mhdimo/Arius80-HE/MUX.kicad_sch

## KiCad design MUX.kicad_sch (2024-11-28)

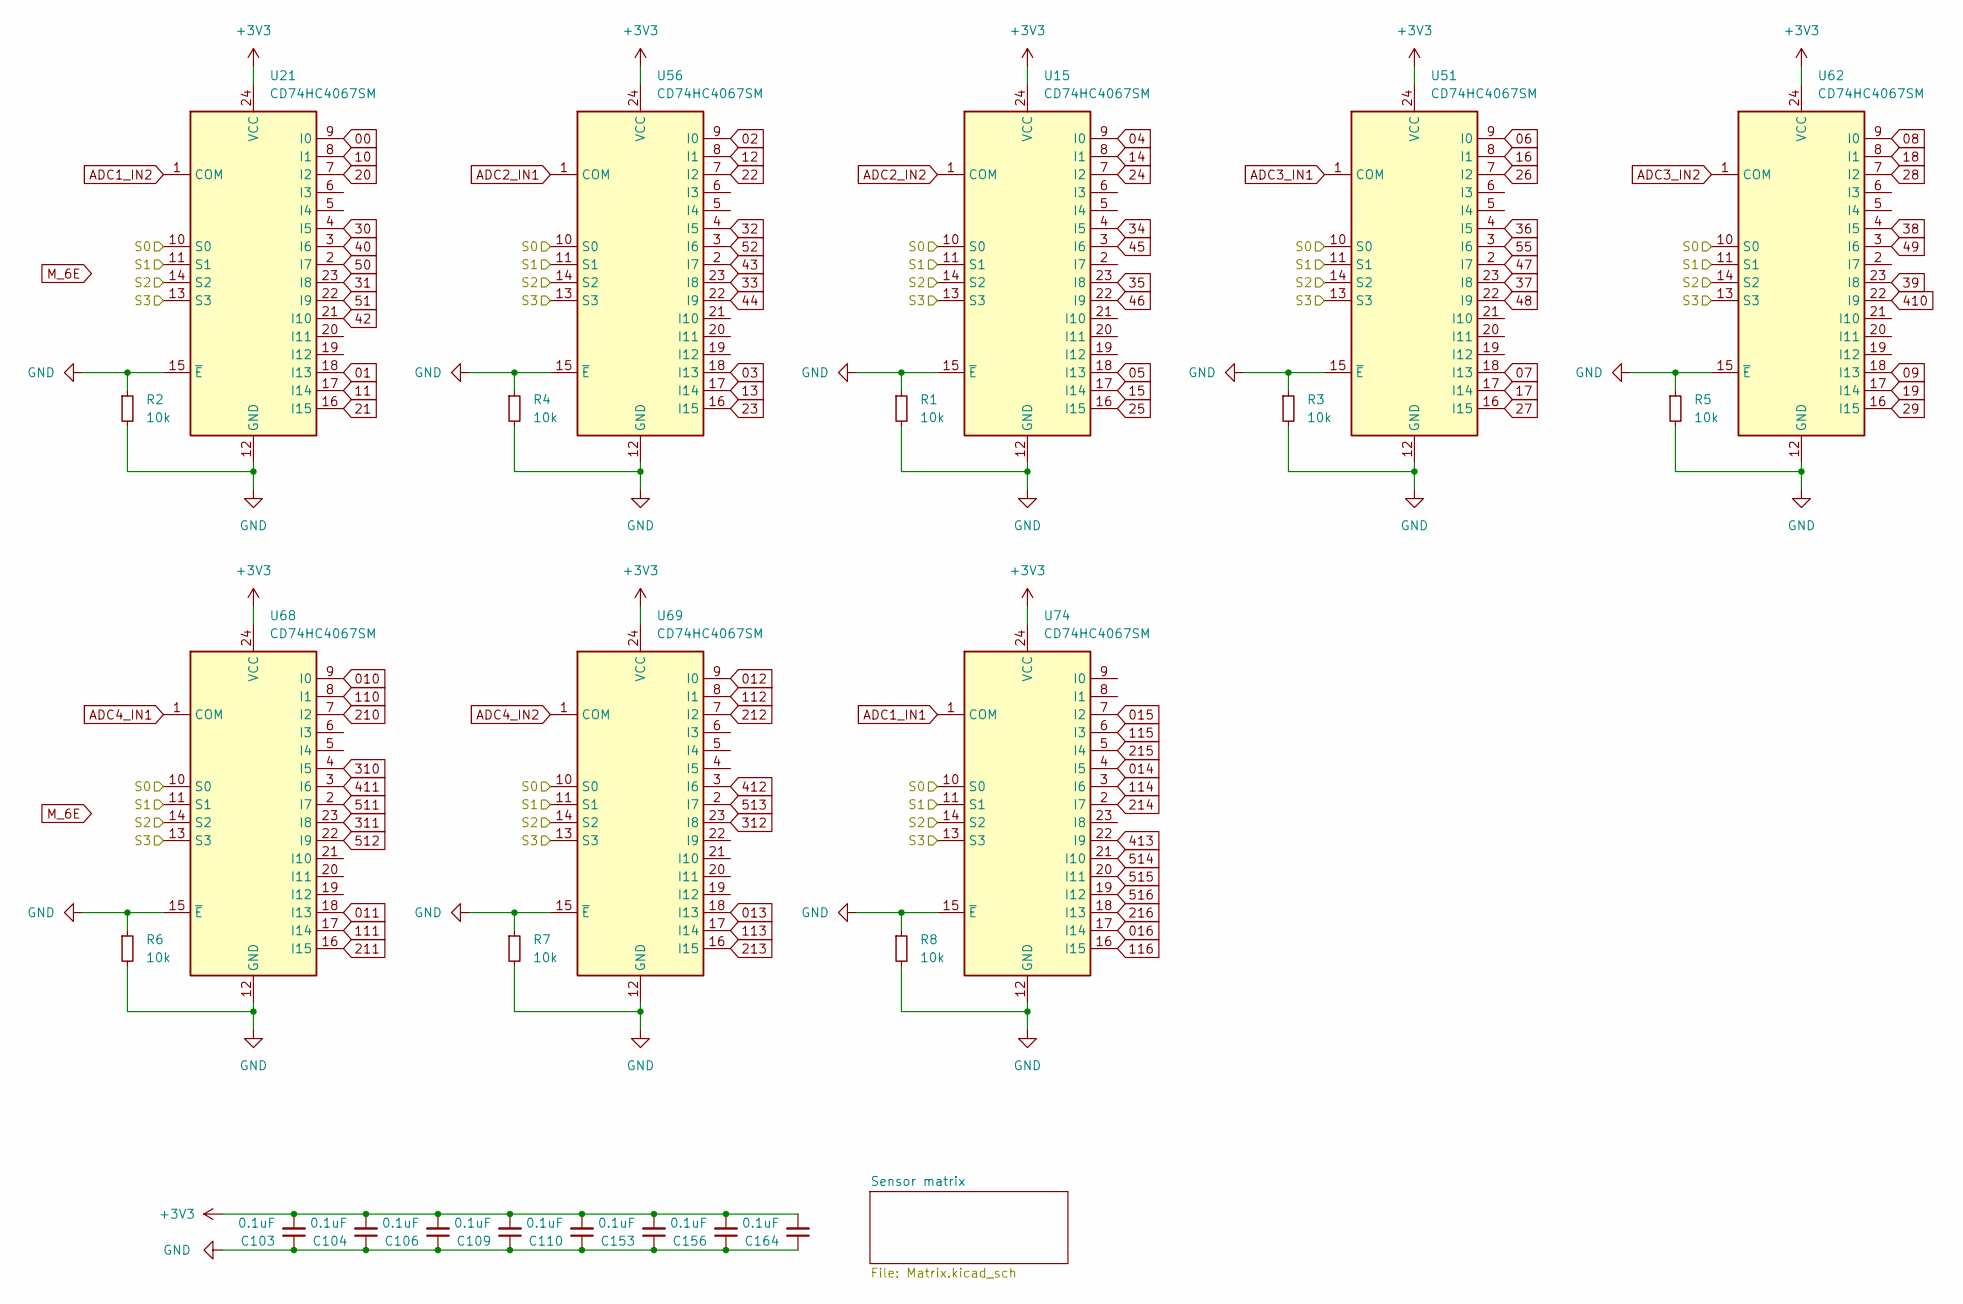
[picture p1: schematic MUX.kicad_sch]

Parts:
C103, C104, C106, C109, C110, C153, C156, C164: 0.1uF; C_0402
R1, R2, R3, R4, R5, R6, R7, R8: 10k; R_0402
U15, U21, U51, U56, U62, U68, U69, U74: CD74HC4067SM; TSSOP-24_4.4x7.8mm_P0.65mm

Connections:
00: U21.9 (I0)
01: U21.18 (I13)
02: U56.9 (I0)
03: U56.18 (I13)
04: U15.9 (I0)
05: U15.18 (I13)
06: U51.9 (I0)
07: U51.18 (I13)
08: U62.9 (I0)
09: U62.18 (I13)
010: U68.9 (I0)
10: U21.8 (I1)
011: U68.18 (I13)
11: U21.17 (I14)
12: U56.8 (I1)
012: U69.9 (I0)
13: U56.17 (I14)
013: U69.18 (I13)
14: U15.8 (I1)
014: U74.4 (I5)
15: U15.17 (I14)
015: U74.7 (I2)
16: U51.8 (I1)
016: U74.17 (I14)
17: U51.17 (I14)
18: U62.8 (I1)
19: U62.17 (I14)
20: U21.7 (I2)
21: U21.16 (I15)
22: U56.7 (I2)
23: U56.16 (I15)
24: U15.7 (I2)
25: U15.16 (I15)
26: U51.7 (I2)
27: U51.16 (I15)
28: U62.7 (I2)
29: U62.16 (I15)
30: U21.4 (I5)
31: U21.23 (I8)
32: U56.4 (I5)
33: U56.23 (I8)
34: U15.4 (I5)
35: U15.23 (I8)
36: U51.4 (I5)
37: U51.23 (I8)
38: U62.4 (I5)
39: U62.23 (I8)
40: U21.3 (I6)
42: U21.21 (I10)
43: U56.2 (I7)
44: U56.22 (I9)
45: U15.3 (I6)
46: U15.22 (I9)
47: U51.2 (I7)
48: U51.22 (I9)
49: U62.3 (I6)
50: U21.2 (I7)
51: U21.22 (I9)
52: U56.3 (I6)
55: U51.3 (I6)
110: U68.8 (I1)
111: U68.17 (I14)
112: U69.8 (I1)
113: U69.17 (I14)
114: U74.3 (I6)
115: U74.6 (I3)
116: U74.16 (I15)
210: U68.7 (I2)
211: U68.16 (I15)
212: U69.7 (I2)
213: U69.16 (I15)
214: U74.2 (I7)
215: U74.5 (I4)
216: U74.18 (I13)
310: U68.4 (I5)
311: U68.23 (I8)
312: U69.23 (I8)
410: U62.22 (I9)
411: U68.3 (I6)
412: U69.3 (I6)
413: U74.22 (I9)
511: U68.2 (I7)
512: U68.22 (I9)
513: U69.2 (I7)
514: U74.21 (I10)
515: U74.20 (I11)
516: U74.19 (I12)
+3V3: C103.2, C104.2, C106.2, C109.2, C110.2, C153.2, C156.2, C164.2, U15.24 (VCC), U21.24 (VCC), U51.24 (VCC), U56.24 (VCC), U62.24 (VCC), U68.24 (VCC), U69.24 (VCC), U74.24 (VCC)
ADC1_IN1: U74.1 (COM)
ADC1_IN2: U21.1 (COM)
ADC2_IN1: U56.1 (COM)
ADC2_IN2: U15.1 (COM)
ADC3_IN1: U51.1 (COM)
ADC3_IN2: U62.1 (COM)
ADC4_IN1: U68.1 (COM)
ADC4_IN2: U69.1 (COM)
GND: C103.1, C104.1, C106.1, C109.1, C110.1, C153.1, C156.1, C164.1, R1.1, R1.2, R2.1, R2.2, R3.1, R3.2, R4.1, R4.2, R5.1, R5.2, R6.1, R6.2, R7.1, R7.2, R8.1, R8.2, U15.12 (GND), U15.15 (~E), U21.12 (GND), U21.15 (~E), U51.12 (GND), U51.15 (~E), U56.12 (GND), U56.15 (~E), U62.12 (GND), U62.15 (~E), U68.12 (GND), U68.15 (~E), U69.12 (GND), U69.15 (~E), U74.12 (GND), U74.15 (~E)
S0: U15.10 (S0), U21.10 (S0), U51.10 (S0), U56.10 (S0), U62.10 (S0), U68.10 (S0), U69.10 (S0), U74.10 (S0)
S1: U15.11 (S1), U21.11 (S1), U51.11 (S1), U56.11 (S1), U62.11 (S1), U68.11 (S1), U69.11 (S1), U74.11 (S1)
S2: U15.14 (S2), U21.14 (S2), U51.14 (S2), U56.14 (S2), U62.14 (S2), U68.14 (S2), U69.14 (S2), U74.14 (S2)
S3: U15.13 (S3), U21.13 (S3), U51.13 (S3), U56.13 (S3), U62.13 (S3), U68.13 (S3), U69.13 (S3), U74.13 (S3)
