mhdimo/Arius80-HE/Matrix.kicad_sch

## KiCad design Matrix.kicad_sch (2024-11-28)

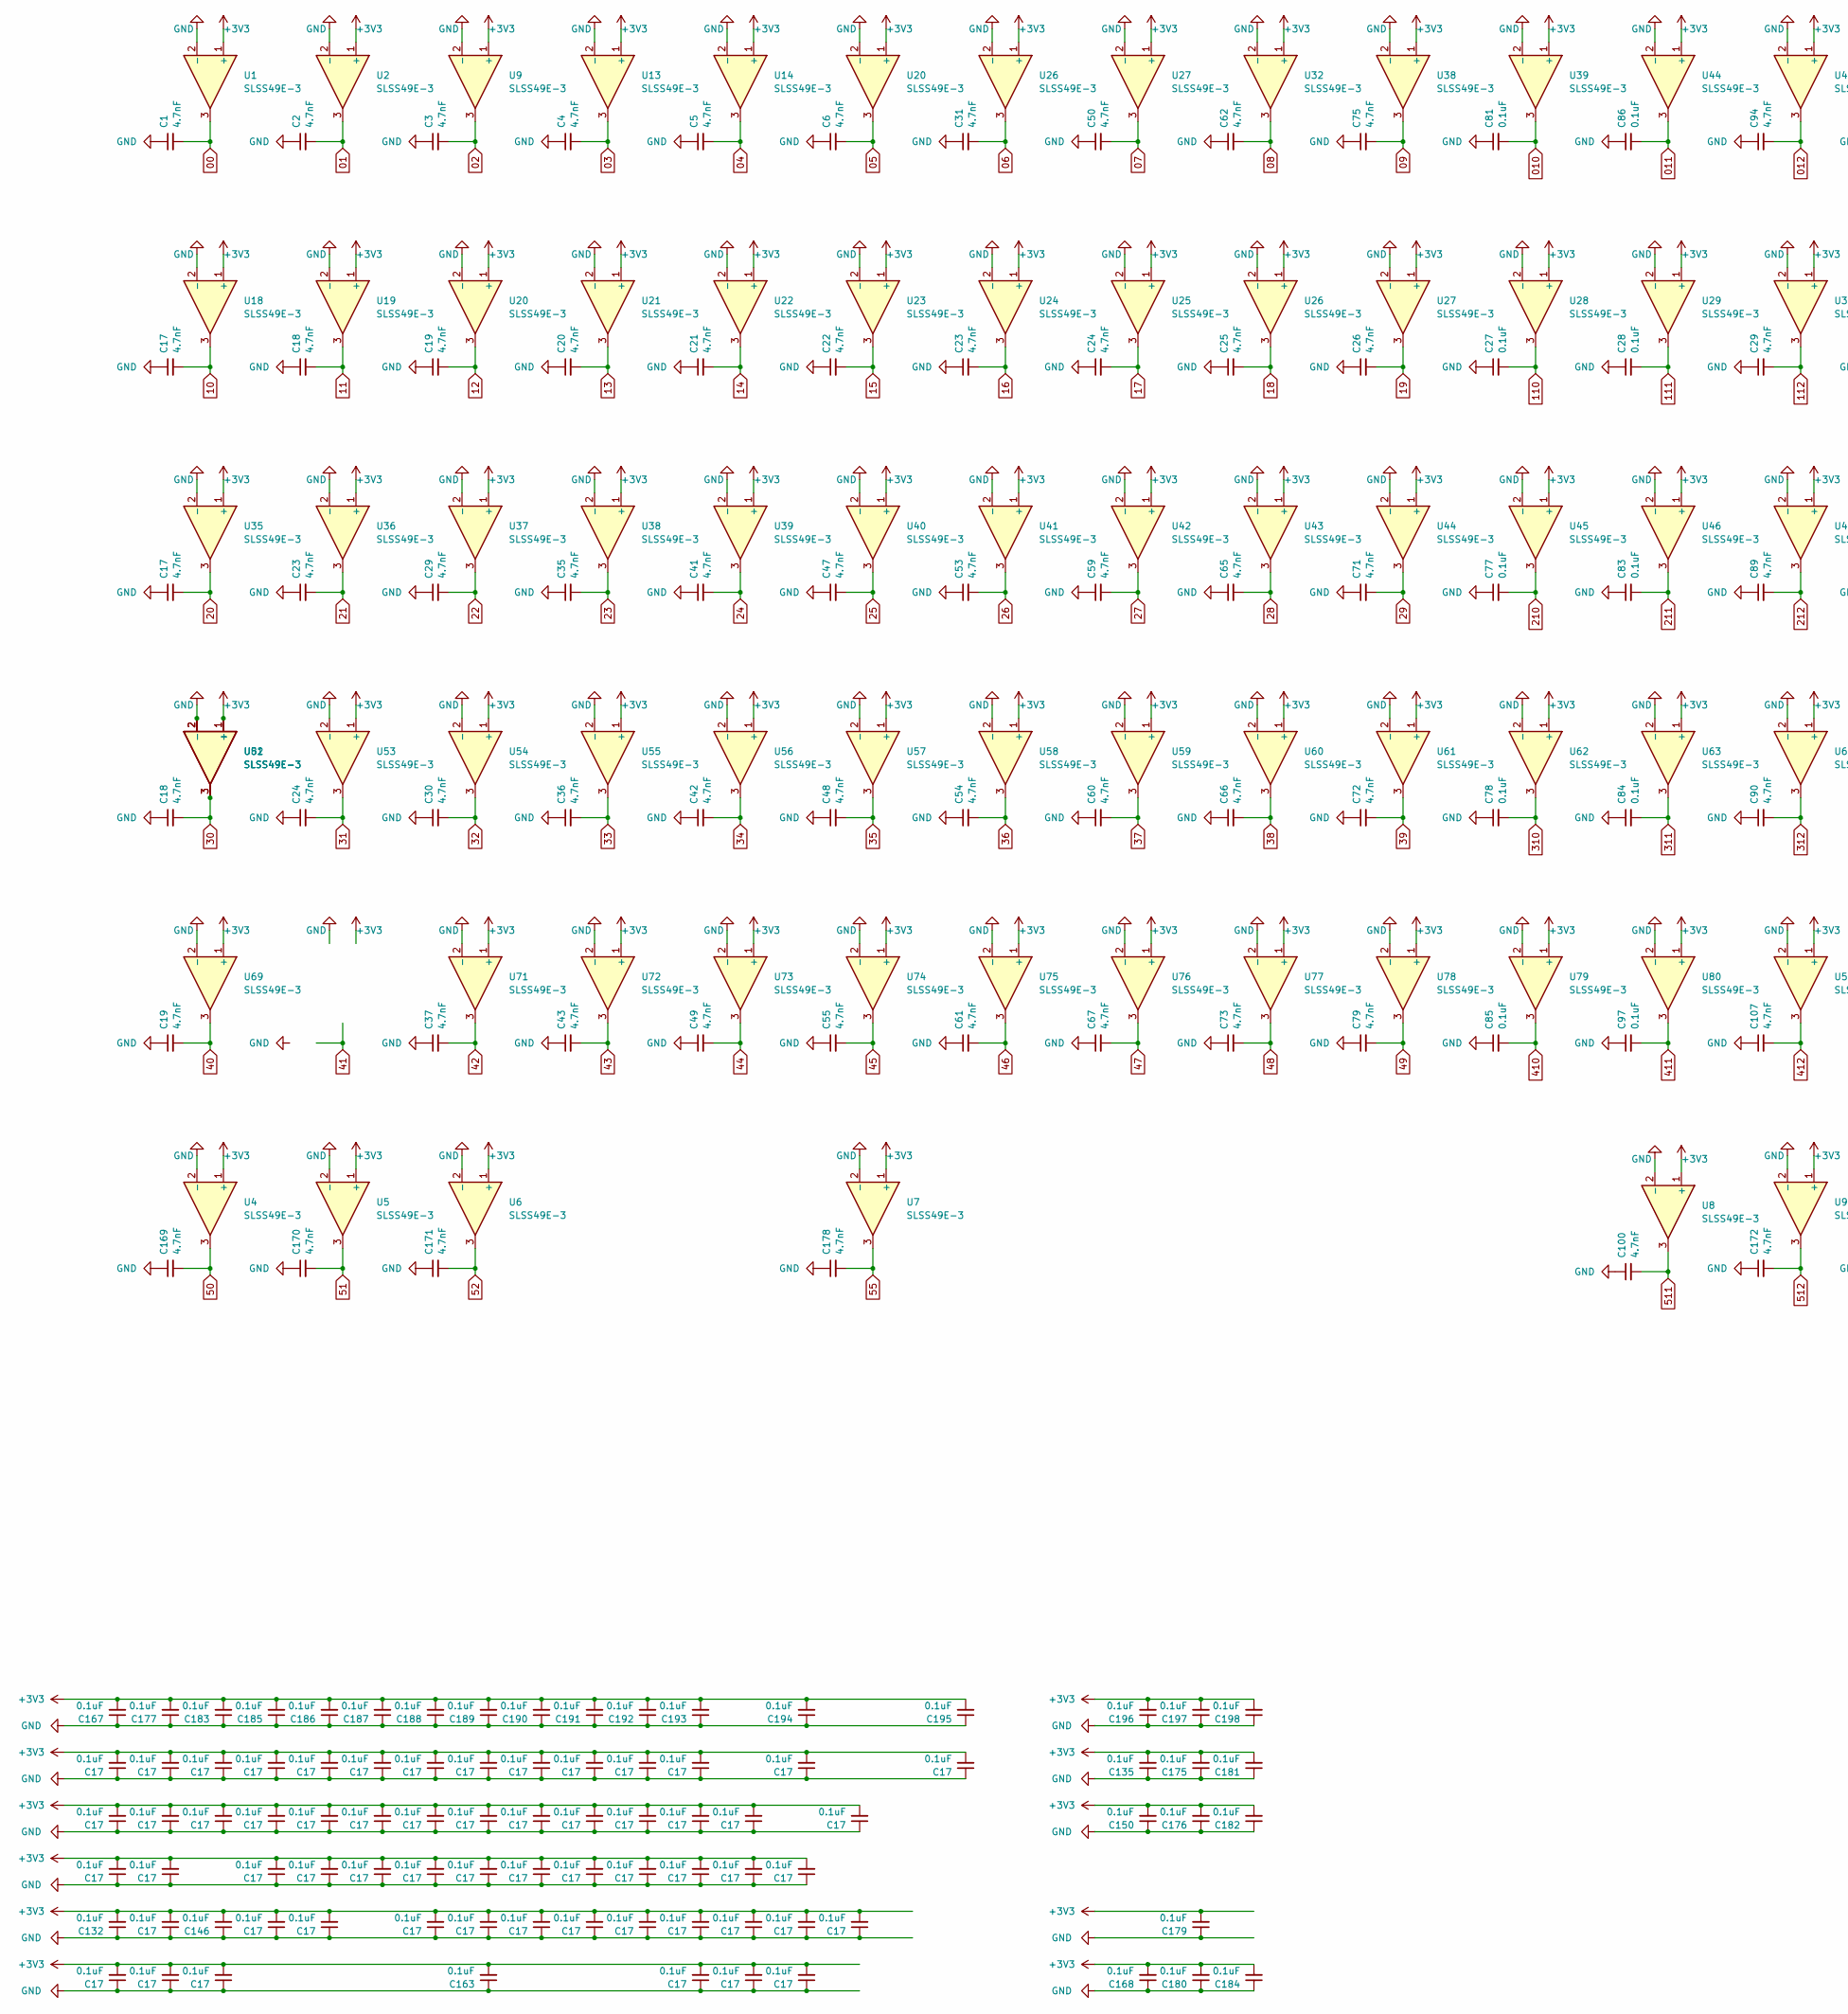
[picture p2: schematic Matrix.kicad_sch, part in row 1, column 1]

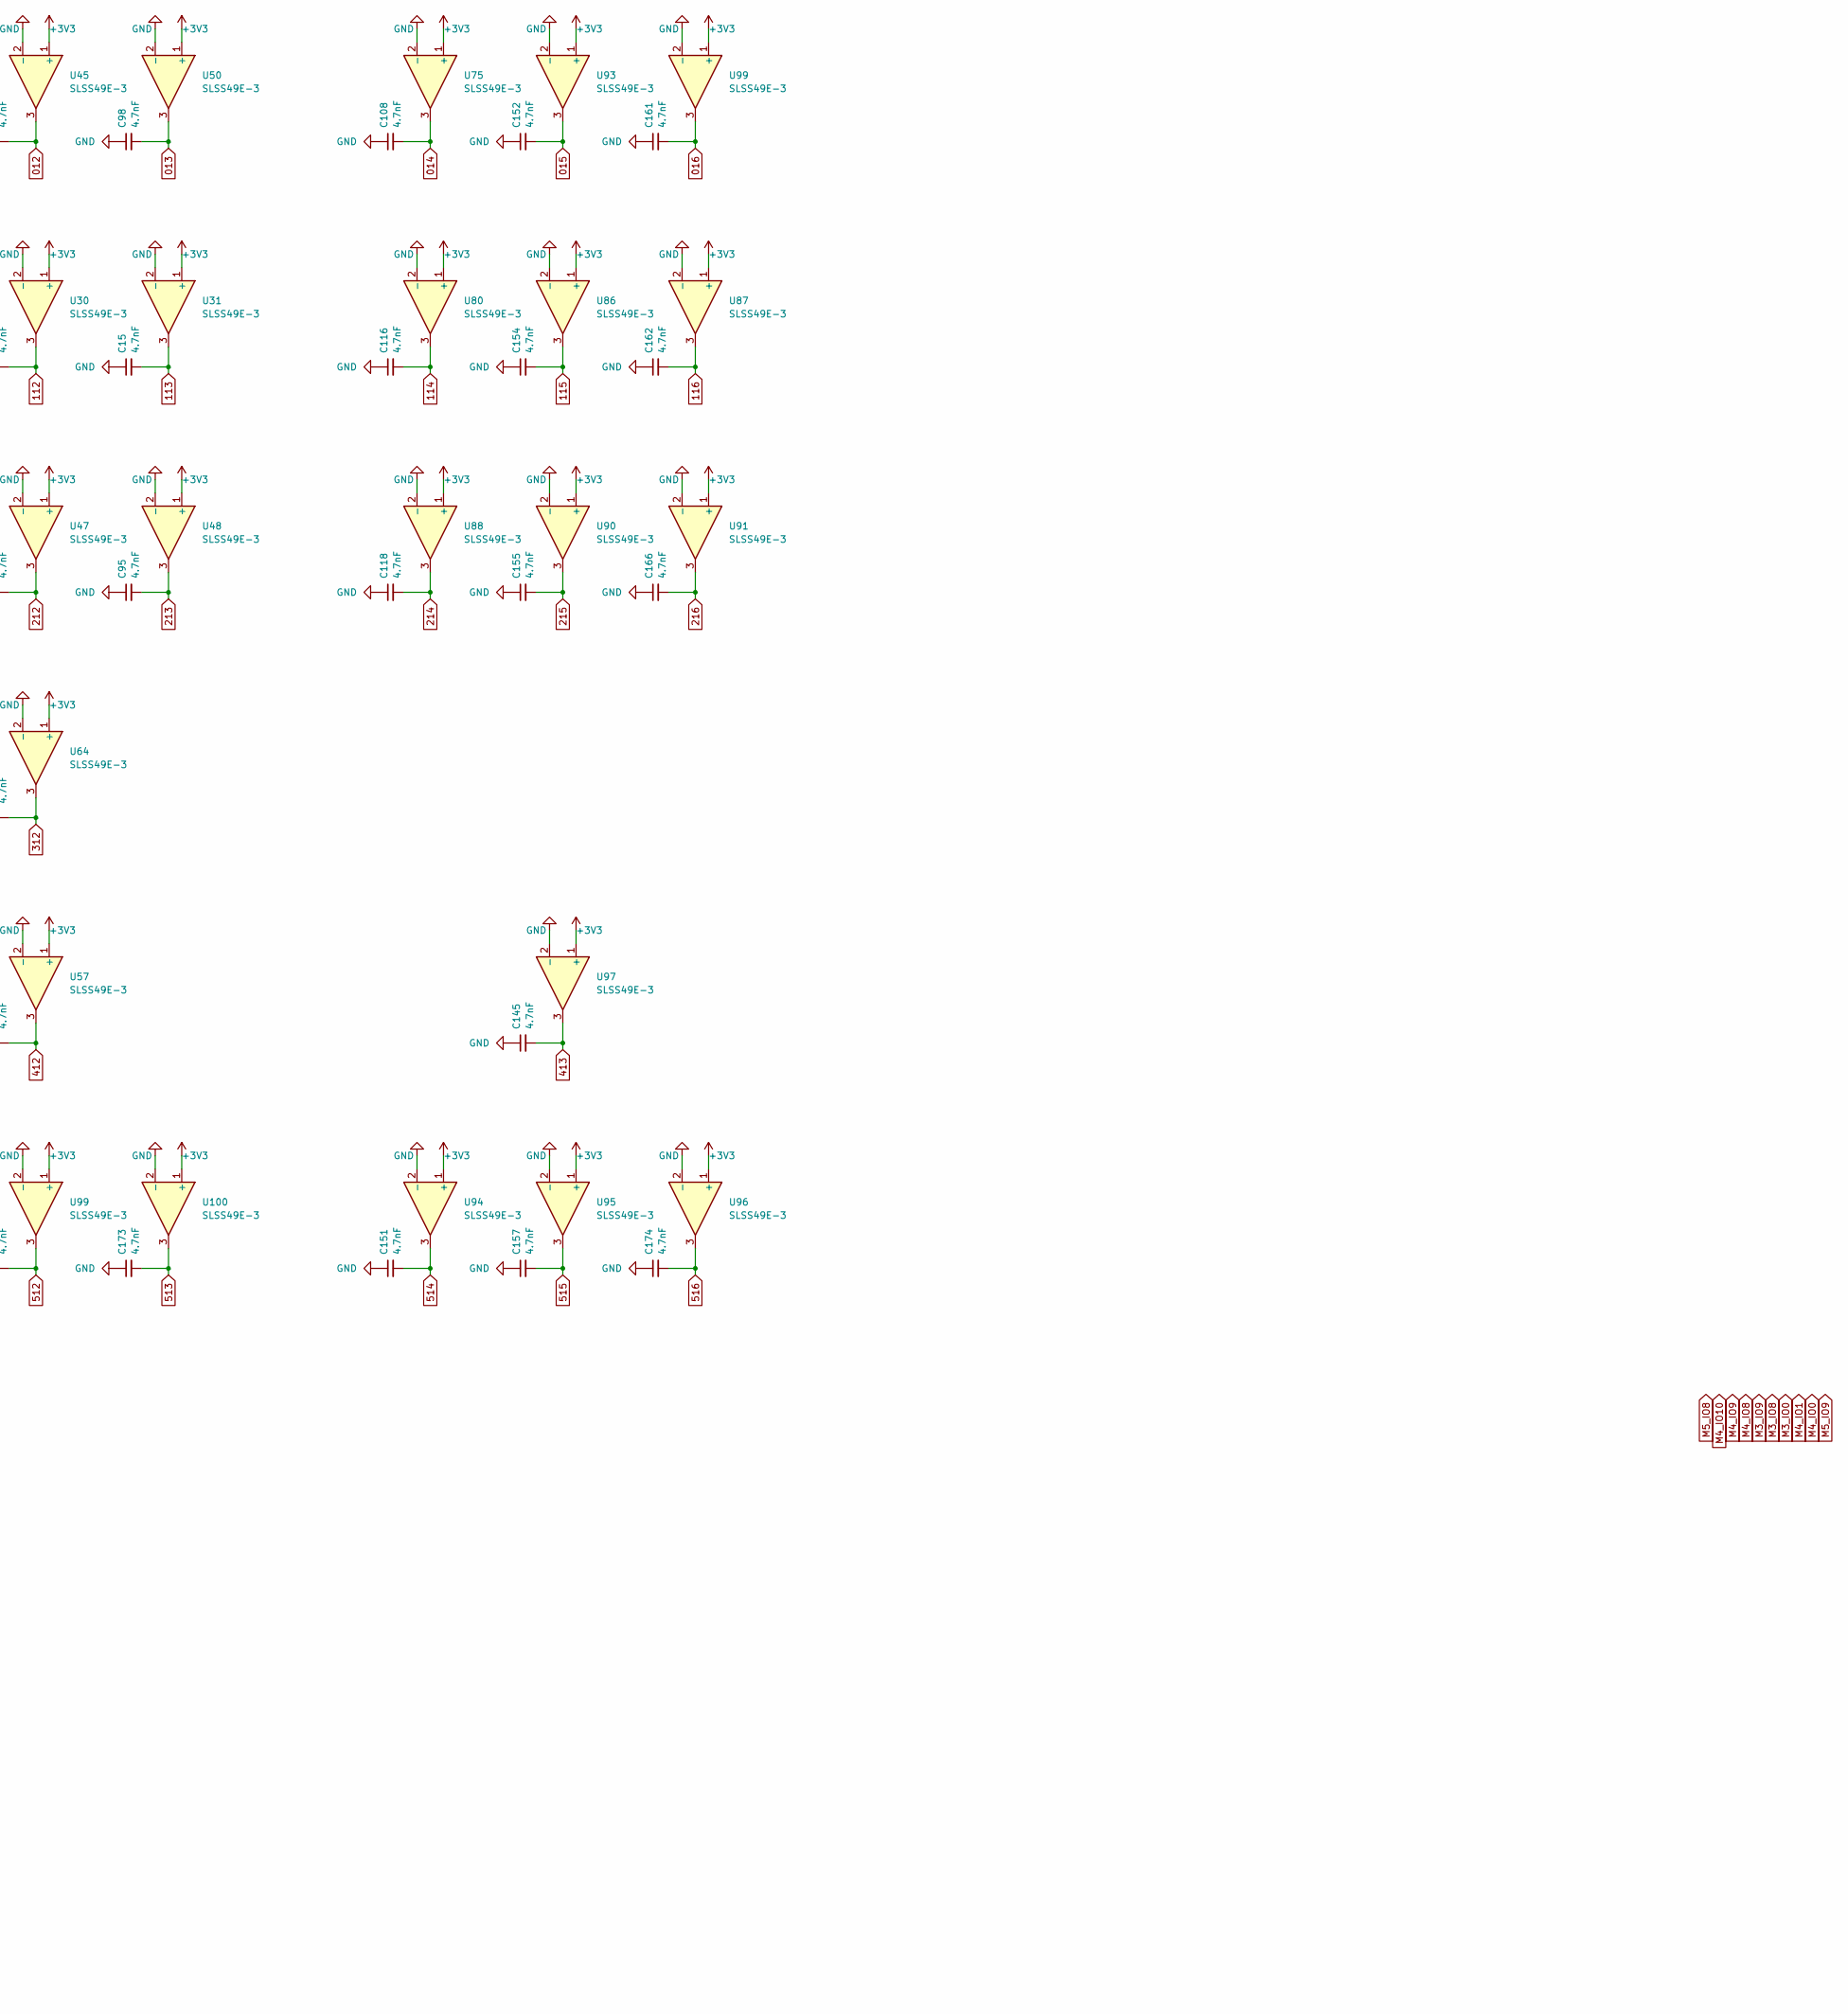
[picture p3: schematic Matrix.kicad_sch, part in row 1, column 2]

Parts:
C1, C2, C3, C4, C5, C6, C15, C18, C19, C20, C21, C22, C23, C24, C25, C26, C29, C30, C31, C35, C36, C37, C41, C42, C43, C47, C48, C49, C50, C53, C54, C55, C59, C60, C61, C62, C65, C66, C67, C71, C72, C73, C75, C79, C89, C90, C94, C95, C98, C100, C107, C108, C116, C118, C145, C151, C152, C154, C155, C157, C161, C162, C166, C169, C170, C171, C172, C173, C174, C178: 4.7nF; C_0402
C17, C27, C28, C77, C78, C81, C83, C84, C85, C86, C97, C132, C135, C146, C150, C163, C167, C168, C175, C176, C177, C179, C180, C181, C182, C183, C184, C185, C186, C187, C188, C189, C190, C191, C192, C193, C194, C195, C196, C197, C198: 0.1uF; C_0402
U1, U2, U5, U9, U13, U14, U18, U19, U20, U21, U22, U23, U24, U25, U26, U27, U28, U29, U30, U32, U36, U37, U38, U39, U40, U41, U42, U43, U44, U45, U46, U47, U50, U53, U54, U55, U56, U57, U58, U59, U60, U61, U62, U63, U71, U72, U73, U74, U75, U76, U77, U78, U79, U80, U86, U87, U88, U90, U91, U93, U94, U95, U96, U97, U99: SLSS49E-3; SLSS49E_MX_1U
U4, U6, U8, U35, U48, U100: SLSS49E-3; SLSS49E_MX_1.5U
U7: SLSS49E-3; SLSS49E_MX_7U-ReversedStabilizers
U31: SLSS49E-3; SLSS49E_MX_2U
U52: SLSS49E-3; SLSS49E_MX_1.75U
U64: SLSS49E-3; SLSS49E_MX_2.25U-ReversedStabilizers
U69: SLSS49E-3; SLSS49E_MX_2.25U
U81: SLSS49E-3; SLSS49E_MX_1.25U

Connections:
00: C1.2, U1.3
01: C2.2, U2.3
02: C3.2, U9.3
03: C4.2, U13.3
04: C5.2, U14.3
05: C6.2, U20.3
06: C31.2, U26.3
07: C50.2, U27.3
08: C62.2, U32.3
09: C75.2, U38.3
10: C17.2, U18.3
010: C81.2, U39.3
011: C86.2, U44.3
11: C18.2, U19.3
012: C94.2, U45.3
12: C19.2, U20.3
13: C20.2, U21.3
013: C98.2, U50.3
14: C21.2, U22.3
014: C108.2, U75.3
015: C152.2, U93.3
15: C22.2, U23.3
016: C161.2, U99.3
16: C23.2, U24.3
17: C24.2, U25.3
18: C25.2, U26.3
19: C26.2, U27.3
20: C17.2, U35.3
21: C23.2, U36.3
22: C29.2, U37.3
23: C35.2, U38.3
24: C41.2, U39.3
25: C47.2, U40.3
26: C53.2, U41.3
27: C59.2, U42.3
28: C65.2, U43.3
29: C71.2, U44.3
30: C18.2, U52.3, U81.3
31: C24.2, U53.3
32: C30.2, U54.3
33: C36.2, U55.3
34: C42.2, U56.3
35: C48.2, U57.3
36: C54.2, U58.3
37: C60.2, U59.3
38: C66.2, U60.3
39: C72.2, U61.3
40: C19.2, U69.3
42: C37.2, U71.3
43: C43.2, U72.3
44: C49.2, U73.3
45: C55.2, U74.3
46: C61.2, U75.3
47: C67.2, U76.3
48: C73.2, U77.3
49: C79.2, U78.3
50: C169.2, U4.3
51: C170.2, U5.3
52: C171.2, U6.3
55: C178.2, U7.3
110: C27.2, U28.3
111: C28.2, U29.3
112: C29.2, U30.3
113: C15.2, U31.3
114: C116.2, U80.3
115: C154.2, U86.3
116: C162.2, U87.3
210: C77.2, U45.3
211: C83.2, U46.3
212: C89.2, U47.3
213: C95.2, U48.3
214: C118.2, U88.3
215: C155.2, U90.3
216: C166.2, U91.3
310: C78.2, U62.3
311: C84.2, U63.3
312: C90.2, U64.3
410: C85.2, U79.3
411: C97.2, U80.3
412: C107.2, U57.3
413: C145.2, U97.3
511: C100.2, U8.3
512: C172.2, U99.3
513: C173.2, U100.3
514: C151.2, U94.3
515: C157.2, U95.3
516: C174.2, U96.3
+3V3: C17.2, C132.2, C135.2, C146.2, C150.2, C163.2, C167.2, C168.2, C175.2, C176.2, C177.2, C179.2, C180.2, C181.2, C182.2, C183.2, C184.2, C185.2, C186.2, C187.2, C188.2, C189.2, C190.2, C191.2, C192.2, C193.2, C194.2, C195.2, C196.2, C197.2, C198.2, U1.1 (+), U2.1 (+), U4.1 (+), U5.1 (+), U6.1 (+), U7.1 (+), U8.1 (+), U9.1 (+), U13.1 (+), U14.1 (+), U18.1 (+), U19.1 (+), U20.1 (+), U21.1 (+), U22.1 (+), U23.1 (+), U24.1 (+), U25.1 (+), U26.1 (+), U27.1 (+), U28.1 (+), U29.1 (+), U30.1 (+), U31.1 (+), U32.1 (+), U35.1 (+), U36.1 (+), U37.1 (+), U38.1 (+), U39.1 (+), U40.1 (+), U41.1 (+), U42.1 (+), U43.1 (+), U44.1 (+), U45.1 (+), U46.1 (+), U47.1 (+), U48.1 (+), U50.1 (+), U52.1 (+), U53.1 (+), U54.1 (+), U55.1 (+), U56.1 (+), U57.1 (+), U58.1 (+), U59.1 (+), U60.1 (+), U61.1 (+), U62.1 (+), U63.1 (+), U64.1 (+), U69.1 (+), U71.1 (+), U72.1 (+), U73.1 (+), U74.1 (+), U75.1 (+), U76.1 (+), U77.1 (+), U78.1 (+), U79.1 (+), U80.1 (+), U81.1 (+), U86.1 (+), U87.1 (+), U88.1 (+), U90.1 (+), U91.1 (+), U93.1 (+), U94.1 (+), U95.1 (+), U96.1 (+), U97.1 (+), U99.1 (+), U100.1 (+)
GND: C1.1, C2.1, C3.1, C4.1, C5.1, C6.1, C15.1, C17.1, C18.1, C19.1, C20.1, C21.1, C22.1, C23.1, C24.1, C25.1, C26.1, C27.1, C28.1, C29.1, C30.1, C31.1, C35.1, C36.1, C37.1, C41.1, C42.1, C43.1, C47.1, C48.1, C49.1, C50.1, C53.1, C54.1, C55.1, C59.1, C60.1, C61.1, C62.1, C65.1, C66.1, C67.1, C71.1, C72.1, C73.1, C75.1, C77.1, C78.1, C79.1, C81.1, C83.1, C84.1, C85.1, C86.1, C89.1, C90.1, C94.1, C95.1, C97.1, C98.1, C100.1, C107.1, C108.1, C116.1, C118.1, C132.1, C135.1, C145.1, C146.1, C150.1, C151.1, C152.1, C154.1, C155.1, C157.1, C161.1, C162.1, C163.1, C166.1, C167.1, C168.1, C169.1, C170.1, C171.1, C172.1, C173.1, C174.1, C175.1, C176.1, C177.1, C178.1, C179.1, C180.1, C181.1, C182.1, C183.1, C184.1, C185.1, C186.1, C187.1, C188.1, C189.1, C190.1, C191.1, C192.1, C193.1, C194.1, C195.1, C196.1, C197.1, C198.1, U1.2 (-), U2.2 (-), U4.2 (-), U5.2 (-), U6.2 (-), U7.2 (-), U8.2 (-), U9.2 (-), U13.2 (-), U14.2 (-), U18.2 (-), U19.2 (-), U20.2 (-), U21.2 (-), U22.2 (-), U23.2 (-), U24.2 (-), U25.2 (-), U26.2 (-), U27.2 (-), U28.2 (-), U29.2 (-), U30.2 (-), U31.2 (-), U32.2 (-), U35.2 (-), U36.2 (-), U37.2 (-), U38.2 (-), U39.2 (-), U40.2 (-), U41.2 (-), U42.2 (-), U43.2 (-), U44.2 (-), U45.2 (-), U46.2 (-), U47.2 (-), U48.2 (-), U50.2 (-), U52.2 (-), U53.2 (-), U54.2 (-), U55.2 (-), U56.2 (-), U57.2 (-), U58.2 (-), U59.2 (-), U60.2 (-), U61.2 (-), U62.2 (-), U63.2 (-), U64.2 (-), U69.2 (-), U71.2 (-), U72.2 (-), U73.2 (-), U74.2 (-), U75.2 (-), U76.2 (-), U77.2 (-), U78.2 (-), U79.2 (-), U80.2 (-), U81.2 (-), U86.2 (-), U87.2 (-), U88.2 (-), U90.2 (-), U91.2 (-), U93.2 (-), U94.2 (-), U95.2 (-), U96.2 (-), U97.2 (-), U99.2 (-), U100.2 (-)
