mhdimo/Arius80-HE/Zellia80.kicad_sch

## KiCad design Zellia80.kicad_sch (2024-11-28)

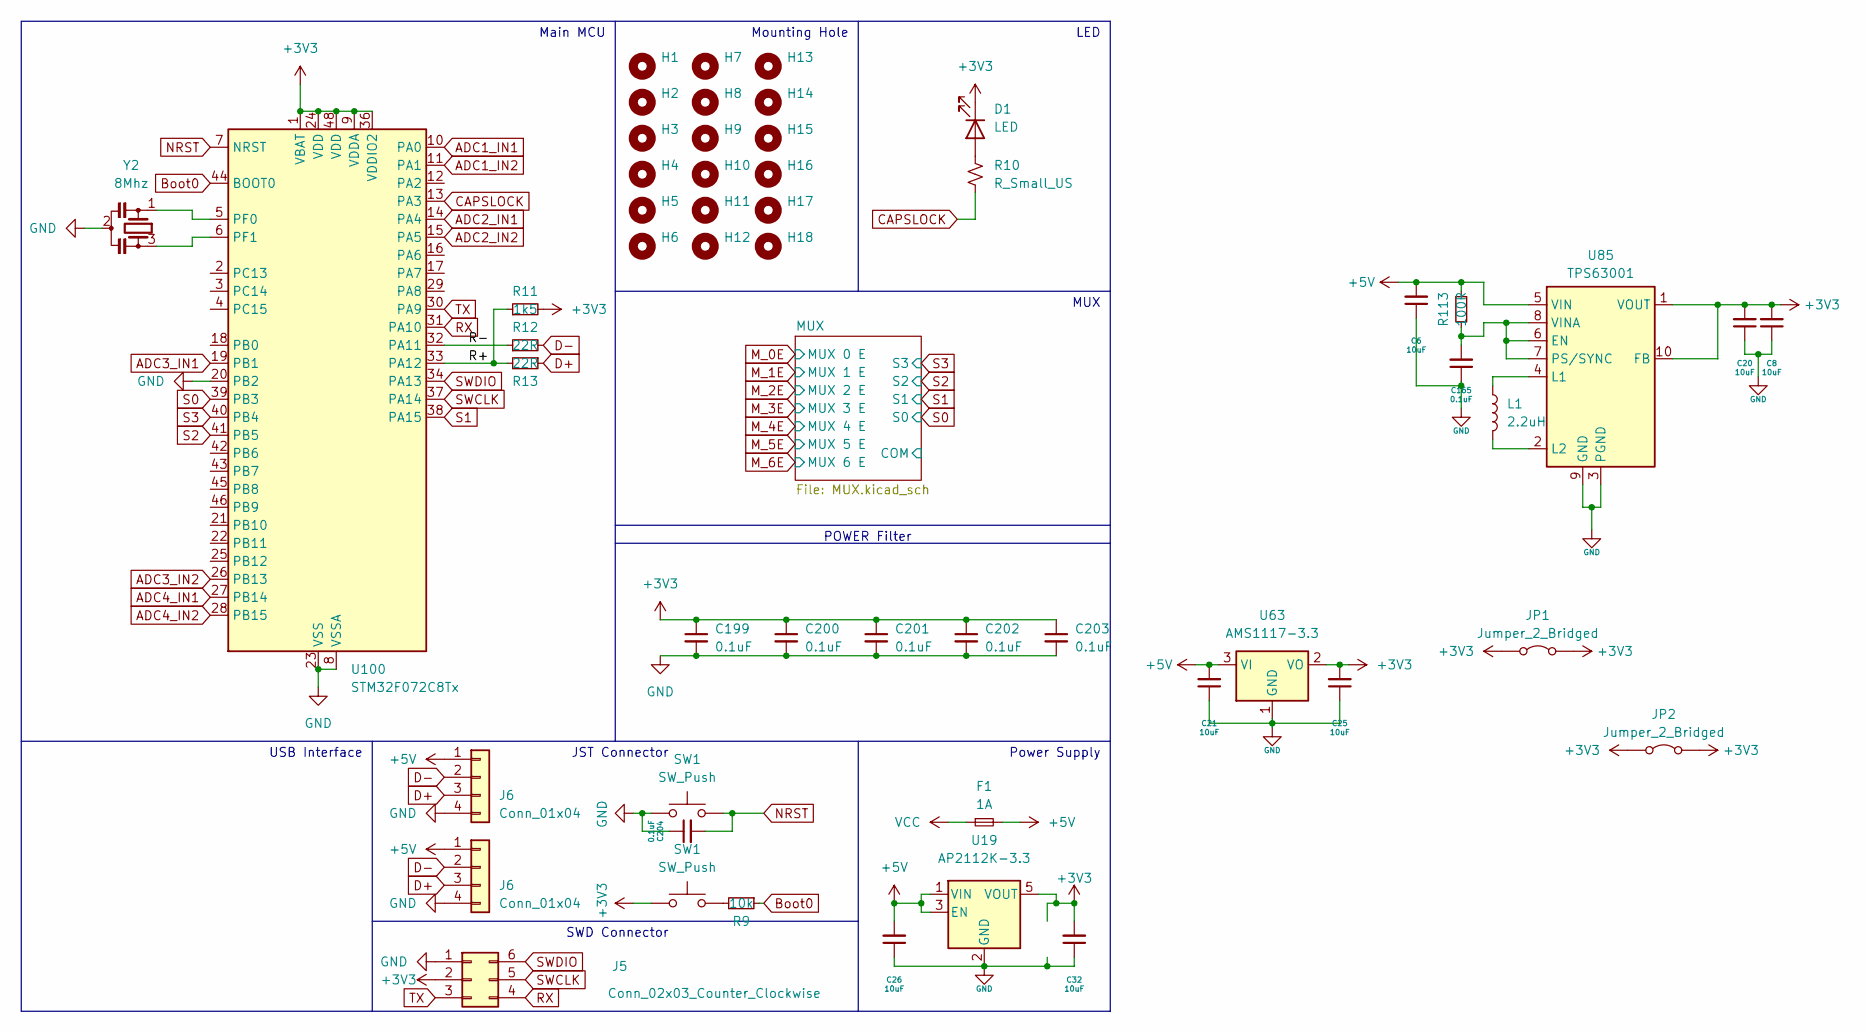
[picture p4: schematic Zellia80.kicad_sch]

Parts:
C6, C8, C20, C21, C25, C26, C32: 10uF; C_0402
C165: 0.1uF; C_0402_1005Metric
C199, C200, C201, C202, C203, C204: 0.1uF; C_0402
D1: LED; LED-6028; LCSC C364964
F1: 1A; Fuse_SMD1206_Reflow
H1, H2, H3, H4, H5, H6, H7, H8, H9, H10, H11, H12, H13, H14, H15, H16, H17, H18: MountingHole; MountingHole_2.5mm_Pad_Via
J5: Conn_02x03_Counter_Clockwise; PinSocket_2x03_P2.54mm_Vertical
J6: Conn_01x04; JST-SR-4
JP1, JP2: Jumper_2_Bridged; SolderJumper-2_P1.3mm_Open_RoundedPad1.0x1.5mm
L1: 2.2uH; L_TDK_NLV25_2.5x2.0mm
R9: 10k; R_0402
R10: R_Small_US; R_0402_1005Metric; LCSC C25117
R11: 1k5; R_0402
R12, R13: 22R; R_0402
R113: 100R; R_0402_1005Metric
SW1: SW_Push; SW_Push_SPST_NO_Alps_SKRK
U19: AP2112K-3.3; SOT-23-5
U63: AMS1117-3.3; SOT-223-3_TabPin2
U85: TPS63001; Texas_DRC0010J_ThermalVias
U100: STM32F072C8Tx; LQFP-48_7x7mm_P0.5mm
Y2: 8Mhz; Resonator_SMD_Murata_CSTxExxV-3Pin_3.0x1.1mm

Connections:
+3V3: C8.2, C20.2, C25.2, C32.2, C199.1, C200.1, C201.1, C202.1, C203.1, D1.1 (K), J5.2, JP1.1 (A), JP1.2 (B), JP2.1 (A), JP2.2 (B), R11.2, SW1.2, U19.5 (VOUT), U63.2 (VO), U85.1 (VOUT), U85.10 (FB), U100.1 (VBAT), U100.9 (VDDA), U100.24 (VDD), U100.36 (VDDIO2), U100.48 (VDD)
+5V: C6.2, C21.2, C26.2, F1.2, J6.1, R113.1, U19.1 (VIN), U19.3 (EN), U63.3 (VI), U85.5 (VIN)
ADC1_IN1: U100.10 (PA0)
ADC1_IN2: U100.11 (PA1)
ADC2_IN1: U100.14 (PA4)
ADC2_IN2: U100.15 (PA5)
ADC3_IN1: U100.19 (PB1)
ADC3_IN2: U100.26 (PB13)
ADC4_IN1: U100.27 (PB14)
ADC4_IN2: U100.28 (PB15)
Boot0: R9.1, U100.44 (BOOT0)
CAPSLOCK: R10.2, U100.13 (PA3)
D+: J6.3, R13.1
D-: J6.2, R12.2
GND: C6.1, C8.1, C20.1, C21.1, C25.1, C26.1, C32.1, C165.1, C199.2, C200.2, C201.2, C202.2, C203.2, C204.1, J5.1, J6.4, SW1.1, U19.2 (GND), U63.1 (GND), U85.3 (PGND), U85.9 (GND), U85.11 (PGND), U100.8 (VSSA), U100.20 (PB2), U100.23 (VSS), U100.35 (VSS), U100.47 (VSS), Y2.2
NRST: C204.2, SW1.2, U100.7 (NRST)
unnamed: C165.2, R113.2, U85.6 (EN), U85.7 (PS/SYNC), U85.8 (VINA)
unnamed: D1.2 (A), R10.1
unnamed: L1.1, U85.4 (L1)
unnamed: L1.2, U85.2 (L2)
unnamed: R9.2, SW1.1
unnamed: U100.5 (PF0), Y2.1
unnamed: U100.6 (PF1), Y2.3
R+: R11.1, R13.2, U100.33 (PA12)
R-: R12.1, U100.32 (PA11)
RX: J5.4, U100.31 (PA10)
S0: U100.39 (PB3)
S1: U100.38 (PA15)
S2: U100.41 (PB5)
S3: U100.40 (PB4)
SWCLK: J5.5, U100.37 (PA14)
SWDIO: J5.6, U100.34 (PA13)
TX: J5.3, U100.30 (PA9)
VCC: F1.1

Notes on the sheet:
JST Connector
Main MCU
MUX
Power Supply
SWD Connector
USB Interface
Mounting Hole
POWER Filter
LED
