mhdimo/Arius80-HE/(commit log)

2023-10-16 Routing and re-routing
    Re-routed MUX outputs to MCU;
    Kinda routed USB, but I don't very like it, so might redo it
    [KBD8X-MKII-HE.kicad_sch]
2023-10-23 fix partially schematic
    [KBD8X-MKII-HE.kicad_sch]
2023-10-23 fix some issues with daughterboard connector
    [KBD8X-MKII-HE.kicad_sch]
2023-10-26 Routed reset/boot button
2023-12-22 maybe good?
    [KBD8X-MKII-HE.kicad_sch]
2023-12-22 maybe last change?
    [KBD8X-MKII-HE.kicad_sch]
2023-12-31 update usb and make schematic prettier
    [KBD8X-MKII-HE.kicad_sch]
2023-12-31 Revert "update usb and make schematic prettier"
    This reverts commit 6420b04975a4f93eedf0b514360bccb39f51c390.
    [KBD8X-MKII-HE.kicad_sch]
2024-01-06 update bom
2024-01-06 update crystal and reroute mux selectors
    [KBD8X-MKII-HE.kicad_sch]
2024-01-06 almost BOM done..
    [KBD8X-MKII-HE.kicad_sch, reset.kicad_sch]
2024-01-08 another CPL attempt fix
    [BOM-KBD8X-MKII-HE.csv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]
2024-01-13 final rename
    [Arius8X-HE.kicad_sch, KBD8X-MKII-HE.kicad_sch]
2024-01-18 change VDDA to 2V instead of 3.3v
    [Arius8X-HE.kicad_sch, keys.kicad_sch, multiplexers.kicad_sch, reset.kicad_sch, sensor.kicad_sch]
2024-01-24 last lcsc remaining
    [Arius8X-HE-CuBottom.gbr, Arius8X-HE-CuTop.gbr, Arius8X-HE-EdgeCuts.gbr, Arius8X-HE-MaskBottom.gbr, Arius8X-HE-MaskTop.gbr, Arius8X-HE-NPTH.drl, Arius8X-HE-PTH.drl, Arius8X-HE-PasteBottom.gbr]
2024-01-24 updated the lcsc of 1.8k resistor
2024-02-06 second rename to Arius
    [Arius80-HE.kicad_sch]
2024-02-06 revert VDDA from 2v to 3.3v
    [Arius80-HE.kicad_sch, keys.kicad_sch, multiplexers.kicad_sch, reset.kicad_sch, sensor.kicad_sch]
2024-02-07 routing VDDA from reference schematic
    [Arius80-HE.kicad_sch]
2024-02-07 added VDDA title
    [Arius80-HE.kicad_sch]
2024-02-08 fix vdda
    [Arius80-HE.kicad_sch]
2024-02-08 added logo and mounting holes
    [Arius80-HE.kicad_sch]
2024-02-10 new usb footprint
    [Arius80-HE.kicad_sch]
2024-02-10 useful for case/plate making.
    [USB Type C Port (SMD Type).STEP]
2024-04-21 fix bom and cpl
    [Arius80-HE-CuBottom.gbr, Arius80-HE-CuTop.gbr, Arius80-HE-EdgeCuts.gbr, Arius80-HE-MaskBottom.gbr, Arius80-HE-MaskTop.gbr, Arius80-HE-NPTH.drl, Arius80-HE-PTH.drl, Arius80-HE-PasteBottom.gbr]
2024-04-21 maybe last update...
    [Arius80-HE-CuBottom.gbr, Arius80-HE-CuTop.gbr, Arius80-HE-EdgeCuts.gbr, Arius80-HE-MaskBottom.gbr, Arius80-HE-MaskTop.gbr, Arius80-HE-NPTH.drl, Arius80-HE-PTH.drl, Arius80-HE-PasteBottom.gbr]
2024-04-22 minor fixes..
    [Arius80-HE-CuBottom.gbr, Arius80-HE-CuTop.gbr, Arius80-HE-EdgeCuts.gbr, Arius80-HE-MaskBottom.gbr, Arius80-HE-MaskTop.gbr, Arius80-HE-NPTH.drl, Arius80-HE-PTH.drl, Arius80-HE-PasteBottom.gbr]
2024-04-22 reworked usb, oscillator
    [Arius80-HE.kicad_sch, multiplexers.kicad_sch]
2024-04-22 last change to bom
    [Arius80-HE-CuBottom.gbr, Arius80-HE-CuTop.gbr, Arius80-HE-EdgeCuts.gbr, Arius80-HE-MaskBottom.gbr, Arius80-HE-MaskTop.gbr, Arius80-HE-NPTH.drl, Arius80-HE-PTH.drl, Arius80-HE-PasteBottom.gbr]
2024-07-24 place one more key
    [Arius80-HE.kicad_sch, keys.kicad_sch, multiplexers.kicad_sch, reset.kicad_sch, sensor.kicad_sch]
2024-07-24 fix swd pin, lead out uart, reorder number
    [Arius80-HE.kicad_sch, keys.kicad_sch, multiplexers.kicad_sch]
2024-07-25 Fix lock files and partially update key labels
    [Arius80-HE.kicad_sch, keys.kicad_sch, multiplexers.kicad_sch, sensor.kicad_sch]
2024-10-25 Update key labels and route progress Mux
    [multiplexers.kicad_sch]
2024-10-26 Update visible layers in Arius80-HE.kicad_prl and add new key labels in multiplexers.kicad_sch
    [Arius80-HE.kicad_sch, multiplexers.kicad_sch]
2024-10-27 just take a look
    [Arius80-HE.kicad_sch]
2024-11-01 add LED caps lock indicator
    [Arius80-HE.kicad_sch, keys.kicad_sch, multiplexers.kicad_sch, reset.kicad_sch, sensor.kicad_sch]
2024-11-02 add capacitors near sensors
    [sensor.kicad_sch]
2024-11-02 Update active layer and modify selection filter settings in Arius80-HE.kicad_prl
2024-11-05 DCDC + LDO routing
    [Arius80-HE.kicad_sch]
2024-11-11 Routing the rest
    [Arius80-HE.kicad_sch]
2024-11-12 Rename Arius80-HE to Zellia80-HE and update active_layer_preset to 'All Layers'
    [Arius80-HE.kicad_sch, Zellia80-HE.kicad_sch, multiplexers.kicad_sch]
2024-11-12 untrack files contained in the .gitignore file
    [Arius80-HE-CuBottom.gbr, Arius80-HE-CuTop.gbr, Arius80-HE-EdgeCuts.gbr, Arius80-HE-MaskBottom.gbr, Arius80-HE-MaskTop.gbr, Arius80-HE-NPTH.drl, Arius80-HE-PTH.drl, Arius80-HE-PasteBottom.gbr]
2024-11-20 hopefully ill finish soon..
    [Zellia80-HE.kicad_sch, keys.kicad_sch, multiplexers.kicad_sch]
2024-11-21 Add new labels and mounting hole symbols to schematic files
    [Zellia80-HE.kicad_sch, multiplexers.kicad_sch]
2024-11-21 Remove everything
    [78171-0004--3DModel-STEP-361473.STEP, USB Type C Port (SMD Type).STEP, Zellia80-HE.kicad_sch, key_filters.kicad_sch, keys.kicad_sch, multiplexers.kicad_sch, reset.kicad_sch, rgb_led.kicad_sch]
2024-11-22 Add New Zellia80 PCB
    [MUX.kicad_sch, Matrix.kicad_sch, Zellia80.kicad_sch]
2024-11-22 Curved Track
    [Zellia80.kicad_sch]
2024-11-23 Add JLC and fix led
    [BOM-Zellia80.csv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]
